Jarank-git/kangertle/CAD/Kangertle_Frame.step

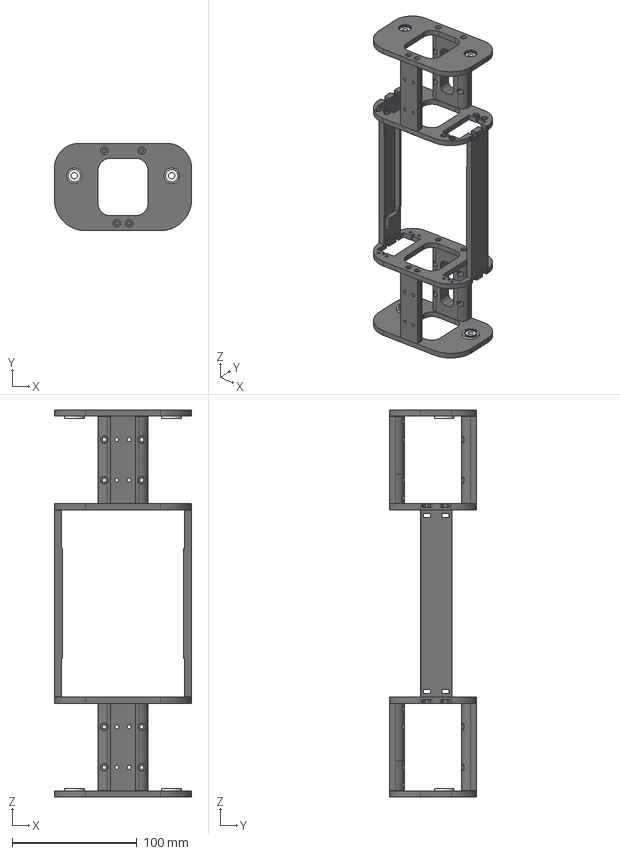
[picture p1: CAD file, 2026-10-23]
CAD/Kangertle_Frame.step
110.0 x 70.0 x 310.0 mm
