Jarank-git/kangertle/CAD/Kangertle_Mounting_Plate.step

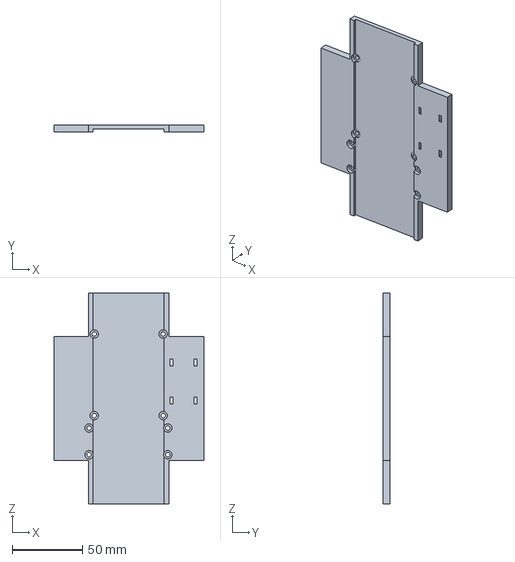
[picture p2: CAD file, 2026-10-23]
CAD/Kangertle_Mounting_Plate.step
106.5 x 5.00 x 150.0 mm
