Jarank-git/kangertle/CAD/Kangertle_Legs.step

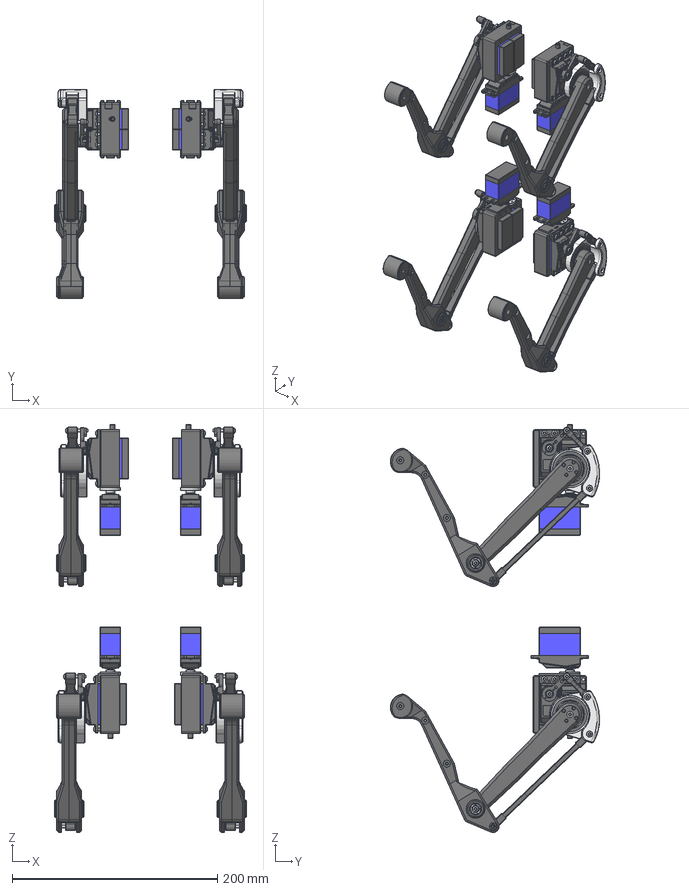
[picture p3: CAD file, 2026-10-23]
CAD/Kangertle_Legs.step
187.2 x 203.7 x 397.2 mm
