Jarank-git/kangertle/CAD/Kangertle_Shell.step

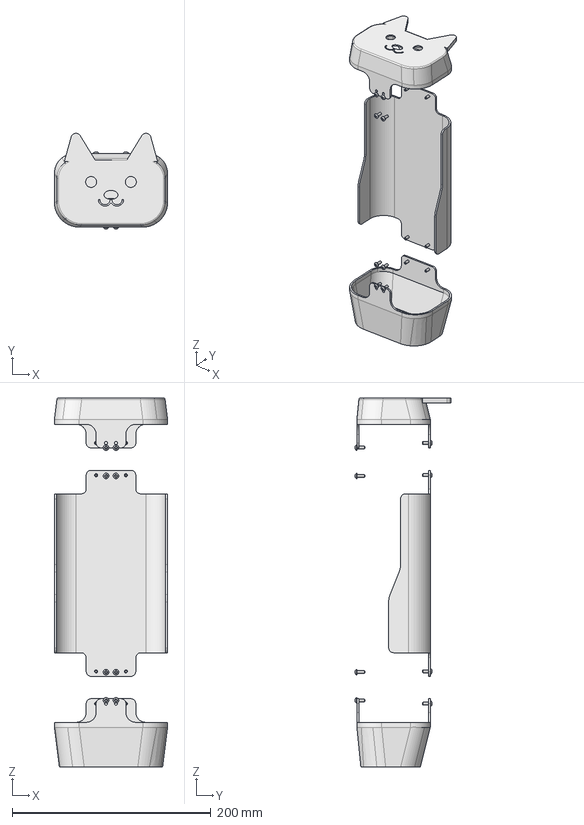
[picture p4: CAD file, 2026-10-23]
CAD/Kangertle_Shell.step
114.0 x 96.2 x 371.5 mm
