Jarank-git/kangertle/(list of files, cad)

Other CAD files:
CAD/Kangertle_Frame.f3d
CAD/Kangertle_Legs.f3d
CAD/Kangertle_Shell.f3d
