Jarank-git/kangertle/(commit log)

2026-10-18 implemening i2c with esp-idf + freeRTOS learnings
2026-10-23 adding cad files
    [Kangertle_Frame.f3d, Kangertle_Frame.step, Kangertle_Legs.f3d, Kangertle_Legs.step, Kangertle_Mounting_Plate.step, Kangertle_Shell.f3d, Kangertle_Shell.step]
2026-10-25 updating code to center all 16 channels at once for assembly
2026-11-09 adding trim to balance out legs
2026-11-09 adding defn for each channel associated with each servo
2026-11-10 direction calibration completed
2026-11-10 overhaul: split main.c into i2c_bus, pca9685, servo and ik modules, restore original comments
2026-11-12 IK incorrect servo spec
2026-11-13 in progress UART terminal with esp32
